cyclotron-bonn/beamposition_controller/KiCaD/regelung_nano/regelung_nano.kicad_sch

## KiCad design KiCaD/regelung_nano/regelung_nano.kicad_sch (2023-12-04, an earlier design)

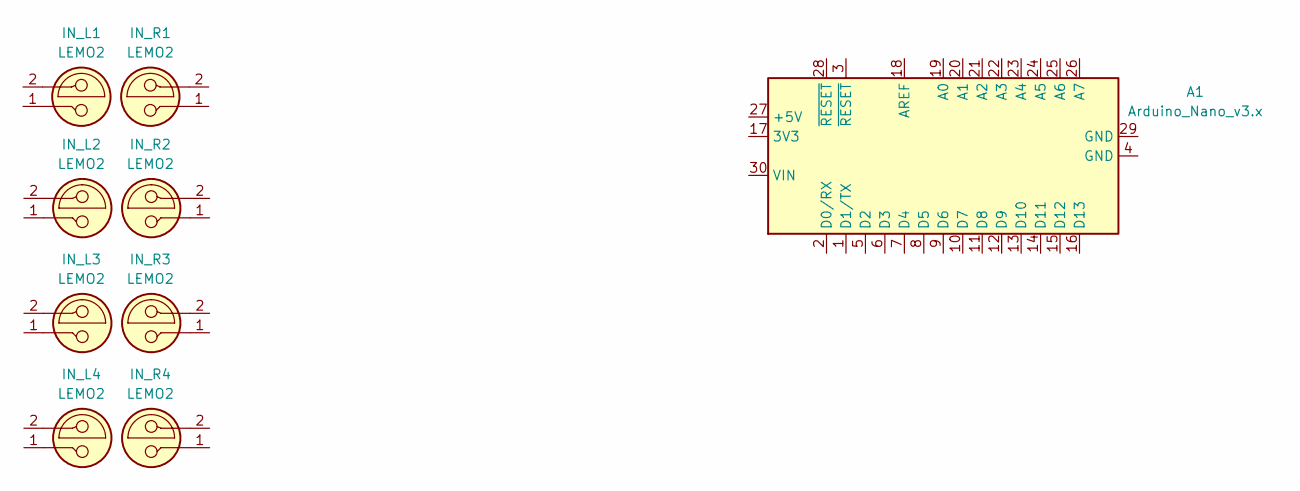
[picture p1: schematic regelung_nano.kicad_sch]

Parts:
A1: Arduino_Nano_v3.x; Arduino_Nano
IN_L1, IN_L2, IN_L3, IN_L4: LEMO2
IN_R1, IN_R2, IN_R3, IN_R4: LEMO2
