cyclotron-bonn/beamposition_controller/(threads)

Thread 1 (2023-01-03):

Communication to DAC-ICs

bedakno, 2023-01-03:
Using the $\text{I}^2\text{C}$ ports for communication limits the usable ADC-channels to 6 instead of 8. Hence one would only be able to measure 3 slit scrape off-currents. This could be fixes by using the SPI interface.
- Are there DACs with SPI communication usable for this application?
- Is the SPI interface fast enough?

bedakno, 2023-08-18:
We use SPI now and all discussions related to the ICs and communication is handled in other issues.

Closed 2023-08-18.

Thread 2 (2023-01-03):

DAC-IC

bedakno, 2023-01-03:
Due to the Arduino Nano not having a DAC on its own and the Arduino Due, which was used in the prototype, the idea is to use an IC carrying a DAC with multiple channels.
As there are a lot of possible choices, this is the place to save ideas, ICs which could be used and requirements the IC must fulfil.
The IC should be available at [Mouser](www.mouser.de) so the website's link to the IC should be attached.

bedakno, 2023-01-25:
https://www.mouser.de/new/texas-instruments/ti-dac70504-dac80504-dacs/
DAC-IC that could be used. Features 50MHz SPI Communication, 5V Output, Gain factor setting, 4 channels, samplingrate of around 1MHz.

leloup314, 2023-01-25:
In principle the IC looks good but tke a look at the package: it is exactly what we talked about. Very difficult to solder manually so I would recommend taking a different footprint

leloup314, 2023-01-29:
This is a nice DAC https://www.mouser.de/ProductDetail/Analog-Devices/AD5686RBRUZ?qs=NmRFExCfTkENVENei53ArQ%3D%3D

leloup314, 2023-01-29:
We can also think about having an external 4 Ch DAC **and** an external 8 Ch ADC, both with 16 bit resolution and SPI interface.
Then the Nano simply just does the communication via SPI (which is quite fast) and the calculation. Would probably be a nicer solution.
One could use such an ADC https://www.mouser.de/ProductDetail/Maxim-Integrated/MAX1168BCEG%2b?qs=d3kjJb5aE2YvByMCteG6qw%3D%3D

bedakno, 2023-04-06:
After browsing again myself, I find the same/similar chips as suggested.
I would propose using following ICs.
DAC: [AD5686BRUZ](https://www.mouser.de/ProductDetail/Maxim-Integrated/MAX1168BCEG%2b?qs=d3kjJb5aE2YvByMCteG6qw%3D%3D)
- 4 channel, 16-bit, SPI, 25MS/s

ADC: [MAX1168BCEG+](https://www.mouser.de/ProductDetail/Analog-Devices/AD5686BRUZ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)
- 8 channel, 16-bit, SPI, 200kS/s

leloup314, 2023-08-14:
- https://www.mouser.de/ProductDetail/Microchip-Technology/MCP3464R-E-ST?qs=W%2FMpXkg%252BdQ5bjobVCBkOgQ%3D%3D
- https://www.mouser.de/ProductDetail/Texas-Instruments/ADS130B04QPWRQ1?qs=Rp5uXu7WBW%2F83WRIW0ul1A%3D%3D

bedakno, 2023-08-18:
I think the [ADS130B04-Q1](https://www.mouser.de/ProductDetail/Texas-Instruments/ADS130B04QPWRQ1?qs=Rp5uXu7WBW%2F83WRIW0ul1A%3D%3D) from Texas Instruments is a good choice.

bedakno, 2023-08-18:
Currently, one can choose between 10-10000nA as full-scale for the IU-conversion. As this won't change, I propose a 120kΩ resistor as 'gain'. 10µA would this way use the full range of the ADC (1.2V) and 10nA would use ~2/3 of the gain 2 setting (±18.75mV). Using this setup would also allow negative beam currents if necessary. Otherwise we could half the gain and shift the incoming voltage to use the full ADC voltage-range. I don't think this is needed as the resolution of 16-bit is probably still far greater than the effective resolution.

leloup314, 2023-08-18:
Sounds good to me :) ICs should be ordered next week

bedakno, 2023-09-13:
In the data sheet of the ADS130B04 I noticed, that AGND to DGND should be between -0.3 and 0.3V. Is that an issue? I remember we discussed that the analog ground should be -1.65V and AVDD 1.65V so that a bipolar signal can be digitised?

leloup314, 2023-09-13:
Well-spotted! This will be a problem. Luckiy, the ADS130B04 states that either analog input can be the following
`Analog input voltage | AINxP, AINxN | min: AGND – 1.6 , max: AVDD + 0.3 V|`

Thread 3 (2023-01-05):

Update 'Fast_IO_Due' library to work with Arduino in use

bedakno, 2023-01-05:
As the Arduino Due exceeds the needed requirements in terms of I/O and is quite a bit larger than sufficient alternatives, it will probably not be used. Hence, the 'Fast_IO_Due' library containing the ADC and DAC adjustments and operations to maximize their capabilities needs to be updated to accommodate the Arduino to be used.
It will probably also be necessary to setup the connection to an external DAC as no Arduino carries more than 2 DAC-Outputs while even more don't carry any DAC at all. This should also be implemented in this new updated library as it should handle all code handling the I/O.

bedakno, 2023-09-27:
Closed, as problem at hand is very different now. New issue with similar topic is opened.

Closed 2023-09-27.

Thread 5 (2023-07-25):

Power supply

leloup314, 2023-07-25:
An possible configuration which would allow us to enable bipolar in- and outputs is the following:

- Have a 5 VDC commercial power supply to power everything
- Use a nice LDO line regulator with charge pump to generate +-5V from the single 5 VDC

Such an IC is the [TI LM27762](https://www.mouser.de/ProductDetail/Texas-Instruments/LM27762DSSR?qs=vcbl%252BK4rRlfEJcC9xQ80sA%3D%3D) which can generate very stable +- 5V from single 5V input while supplying +-250 mA current (Looks like this is the maximum the Nano board should consume (see [here](https://arduino.stackexchange.com/questions/926/what-is-the-maximum-power-consumption-of-the-arduino-nano-3-0)). The other ICs on the PCB should not consume a lot so I think this yould be a nice solution to get bipolar +- 5V

leloup314, 2023-08-19:
The TI LM27762 should be used to provide +- 1.65 V ( 3V3 / 2) for powering our transimpedance amps as well as our ADCs (AGND & AVDD, DGND & DVDD should be 0-3V3 from Arduino)

leloup314, 2023-08-19:
The TI LM27762 as well as the Arduino (VIN pin, has LDO so no need to regulate) should be powered from the 5VDC power supply

leloup314, 2023-08-19:
We should use a 5V LDO e.g. [LDL1117S50R](https://www.mouser.de/ProductDetail/STMicroelectronics/LDL1117S50R?qs=AQlKX63v8RsuN9BQFiVf%2Fg%3D%3D) to produce the 5 V rail for the LM27762 and use a 9 VDC power supply. This we feed in the VIN of arduino since the 5V on VIN is quite low for the on-board LDO to properly work.

Thread 6 (2023-08-19):

Transimpedance amplifiers

leloup314, 2023-08-19:
Since we are using a 4 ch ADC, we can use the [AD8618](https://www.analog.com/en/products/ad8618.html) 4 ch loww-offset amplifier for the transimpedance amplification

leloup314, 2023-08-19:
Keep in mind the sign of the input current: for ions the current will be positive, for electrons negative. For normal controller operation, we therefore expect a positive current which will result in a negative voltage output.

Thread 8 (2023-09-27):

General discussion about the Arduino firmware

bedakno, 2023-09-27:
Should the control for the two separate slit pairs also be cleanly separated in the code? E.g. each slit pair has its own instance of a control. Alternatively, one could just ignore the second slit pair and make it impossible (error) when trying to access it. As the used DAC has 4 channels as of now, one would have to implement such a way there anyway as both controls would share the DAC, but not its channels obviously.

leloup314, 2023-09-27:
I think that is a good idea: the most minimal yet complete control flow contains 2 slits for control of 1 respective dimension. In the code, you can have something like a `PlaneController` which controls exactly one plane e.g. has input of two corresponding quantities and outputs one control quantity.
Then, in the software interface, we define the how many pairs are connected to the controller: either 1 or 2.

Thread 9 (2023-10-17):

ADS130B04 SPI library - Arduino

bedakno, 2023-10-17:
The library ADS130B04 should handle all communication and storing of the ADC status. It is designed to be implemented on an Arduino which further processes the data/acts as a translation layer between user and ADC. In general, the library can also be rewritten to be used without an Arduino. The only "Arduino commands" are concerning the SPI communication with the IC.

bedakno, 2023-10-17:
I will keep enhancements posted as well as any bug I come across.

leloup314, 2023-10-22:
Sorry for the late reaction, quite the busy week. Looks nice!

bedakno, 2023-12-04:
Bugs encountered during today's testing:
- ADC is in 32-bit LSB-zero padded mode at start
