cyclotron-bonn/beamposition_controller/(commit log)

2023-01-03 ADD: migrate data from extraction_control and add functionality for multiple controller instances on one arduino
    [regelung_nano.kicad_pcb, regelung_nano.kicad_sch]
2023-01-18 ENH: enhance capabilities
    [regelung_nano.kicad_sch]
2023-01-25 FIX: delete @property as it does not work here
    [regelung_nano.kicad_pcb]
2023-02-13 ENH: simplifed io controlling as external ics are used and implemented spi interface
2023-02-14 ENH: choose correct adc/dac channel automatically, remove option to set them via serial
    [Controller.ino, arduino_controller.py]
2023-02-15 ENH: avoid index out of bound on arduino so it does not crash when accessing a none existing controller via serial
    [Controller.ino]
2023-02-21 FIX: Serial communication and controller itself
    [Controller.ino, arduino_controller.py]
2023-04-20 ENH:updated schematik for ICs to use
    [regelung_nano.kicad_sch]
2023-04-20 ENH: working on future spi communication with ICs
2023-07-13 FIX: controller now working properly. details need to be looked into -> testing with adc and dac ready using signal generator and osci
    [Controller.ino]
2023-07-25 FIX: adc communication via SPI now working via given SPIComm library
    [regelung_nano.kicad_sch]
2023-07-25 DEL: ArduinoSTL library
2023-10-03 ADD: change SPI library to work with ADC in use
    [regelung_nano.kicad_sch]
2023-10-03 ENH: fixes in SPIComm
    [SPItest.ino]
2023-10-10 ENH: change name of adc library and fix it
    [SPItest.ino]
2023-10-12 ENH: improved functionality of ADC library
2023-12-04 FIX: change SPI.transfer16() to self-made function as arduino in use doesn't fully support feature
    [SPItest.ino]
2023-12-04 ENH: update schematic
    [regelung_nano.kicad_sch]
2023-12-04 ENH:add setup() which sets the device up depending on the current settings of the adc
2023-12-07 ENH: improve schematic
